ultimachine/RAMBo-1.4/Project Outputs/Assembly/BOM-Grouped_RAMBo_1.4a.xlsx

Designator | DISTRIBUTOR | DISTRIBUTOR # | Manufacturer | MANUFACTURER # | PART | Quantity | DNI | Comment | Footprint | Description | Part Description | VALUE | Tolerance | EE_SPEC
C1, C12, C13, C57, C58 |  |  | TDK | C1608C0G1H220J |  | 5 |  | 22pF | C0603 | CAPACITOR, European symbol |  |  |  | 22pF 50V capacitor
C2 |  |  | Kemet | C0805C106K8PACTU |  | 1 |  | 10uF | C0805 | CAPACITOR, American symbol |  |  |  | 10uF
C3, C5, C6, C7, C8, C9, C19, C20, C21, C26, C52, C53, C56, C59, C64, C78, C86, C87, C88, C89, C90, C91, C92, C93, C94, C95, C96, C97 | Digi-Key, [NoParam], Digikey, Digikey, Digikey, Digikey, [NoParam], [NoParam], [NoParam], Digikey, Digikey, Digi-Key, Digi-Key, Digi-Key, Digi-Key, Digikey, [NoParam], [NoParam], [NoParam], [NoParam], [NoParam], [NoParam], Digikey, Digikey, Digikey, Digikey, Digi-Key, Digikey | 490-3261-2-ND | Murata | GRM155R71C104KA88D | 100nF, [NoParam], 0.1uF 16V X7R 0402, 0.1uF 16V X7R 0402, 0.1uF 16V X7R 0402, 0.1uF 16V X7R 0402, [NoParam], [NoParam], [NoParam], 0.1uF 16V X7R 0402, 0.1uF 16V X7R 0402, 100nF, 100nF, 100nF, 100nF, 0.1uF 16V X7R 0402, [NoParam], [NoParam], [NoParam], [NoParam], [NoParam], [NoParam], 0.1uF 16V X7R 0402, 0.1uF 16V X7R 0402, 0.1uF 16V X7R 0402, 0.1uF 16V X7R 0402, 100nF, 0.1uF 16V X7R 0402 | 28 |  | 100nF | C0402 | CAP CER 0402 100nF 16V 10% X7R, CAPACITOR, European symbol, CAP CER 0402 100nF 16V 10% X7R, CAP CER 0402 100nF 16V 10% X7R, CAP CER 0402 100nF 16V 10% X7R, CAP CER 0402 100nF 16V 10% X7R, CAPACITOR, European symbol, CAPACITOR, European symbol, CAPACITOR, European symbol, CAP CER 0402 100nF 16V 10% X7R, CAP CER 0402 100nF 16V 10% X7R, CAP CER 0402 100nF 16V 10% X7R, CAP CER 0402 100nF 16V 10% X7R, CAP CER 0402 100nF 16V 10% X7R, CAP CER 0402 100nF 16V 10% X7R, CAP CER 0402 100nF 16V 10% X7R, CAPACITOR, European symbol, CAPACITOR, European symbol, CAPACITOR, European symbol, CAPACITOR, European symbol, CAPACITOR, European symbol, CAPACITOR, European symbol, CAP CER 0402 100nF 16V 10% X7R, CAP CER 0402 100nF 16V 10% X7R, CAP CER 0402 100nF 16V 10% X7R, CAP CER 0402 100nF 16V 10% X7R, CAP CER 0402 100nF 16V 10% X7R, CAP CER 0402 100nF 16V 10% X7R | 0.10µF ±10% 16V Ceramic Capacitor X7R 0402 (1005 Metric) | 100nF | +/- 10%, [NoParam], 10%, 10%, 10%, 10%, [NoParam], [NoParam], [NoParam], 10%, 10%, +/- 10%, +/- 10%, +/- 10%, +/- 10%, 10%, [NoParam], [NoParam], [NoParam], [NoParam], [NoParam], [NoParam], 10%, 10%, 10%, 10%, +/- 10%, 10% | 100nF 16V X7R 0402, 16V, 16V, 16V, 16V, 16V, 16V, 16V, 16V, 16V, 16V, 100nF 16V X7R 0402, 100nF 16V X7R 0402, 100nF 16V X7R 0402, 100nF 16V X7R 0402, 16V, 16V, 16V, 16V, 16V, 16V, 16V, 16V, 16V, 16V, 16V, 100nF 16V X7R 0402, 16V
C4, C10, C11, C14, C15, C17, C18, C23, C24, C27, C28, C29, C32, C33, C34, C37, C38, C39, C42, C43, C44, C47, C48, C49, C55, C60, C62, C71, C72, C73, C74, C75 |  |  | Kemet, Kemet, Kemet, Kemet, Kemet, Kemet, Kemet, Kemet, Kemet, Kemet, Kemet, Kemet, Kemet, Kemet, Kemet, Kemet, Kemet, Kemet, Kemet, Kemet, Kemet, Kemet, Kemet, Kemet, Kemet, [NoValue], [NoValue], Kemet, Kemet, Kemet, Kemet, Kemet | C0603C104K5RACTU |  | 32 |  | 100nF | C0603 | CAPACITOR, European symbol, CAPACITOR, European symbol, CAPACITOR, European symbol, CAPACITOR, European symbol, CAPACITOR, European symbol, CAPACITOR, European symbol, CAPACITOR, European symbol, CAPACITOR, European symbol, CAPACITOR, European symbol, CAPACITOR, European symbol, CAPACITOR, European symbol, CAPACITOR, European symbol, CAPACITOR, European symbol, CAPACITOR, European symbol, CAPACITOR, European symbol, CAPACITOR, European symbol, CAPACITOR, European symbol, CAPACITOR, European symbol, CAPACITOR, European symbol, CAPACITOR, European symbol, CAPACITOR, European symbol, CAPACITOR, European symbol, CAPACITOR, European symbol, CAPACITOR, European symbol, CAPACITOR, European symbol, CAP CER 0603 100nF 50V 10% X7R, CAP CER 0603 100nF 50V 10% X7R, CAPACITOR, European symbol, CAPACITOR, European symbol, CAPACITOR, European symbol, CAPACITOR, European symbol, CAPACITOR, European symbol |  |  |  | 0.1uF 50V capacitor
C16 |  |  | yageo | CC0603ZRY5V6BB105 |  | 1 |  | 1uF | C0603 | CAPACITOR, European symbol |  |  |  | 1uF 10V capacitor
C22, C50, C61, C67, C68, C69, C70, C77, C79, C80, C81, C82, C83, C84, C85 |  |  | Murata | GRM1555C1H101JA01D |  | 15 |  | 100pF | C0402 | Capacitor Non Polarized |  | C0402TBD |  | 100pF ±5% 50V Ceramic Capacitor C0G, NP0 0402 (1005 Metric)
C25, C30, C45 | Digikey | 490-9964-2-ND | Murata | GRM319R6YA106KA12D | 10uF 35V X5R 1206 | 3 | DNI | 10uF | C1206 | CAP CER 10UF 35V 10% X5R 1206 | 10µF ±10% 35V Ceramic Capacitor X5R 1206 (3216 Metric) | 10uF | 10% | 35V
C31, C36, C41, C46, C51 |  |  | Yageo | CC0603KRX7R7BB224 |  | 5 |  | 0.22uF | C0603 | CAPACITOR, European symbol |  |  |  | 0.22uF 100V capacitor X or 15%
C35, C54 |  |  | TDK | C1608X7R1E103K080AA |  | 2 |  | 10nF | C0603 | CAPACITOR, American symbol |  |  |  | 10nF (0.01uF) 25V capacitor
C40 |  |  | Murata | GRM21BR71H105KA12L |  | 1 |  | 1uF | C0805 | CAPACITOR, American symbol |  |  |  | Multilayer Ceramic Capacitors MLCC - SMD/SMT 1.0UF 50V 10% 0805
C63 |  |  |  | CC0402KRX7R8BB472 |  | 1 |  | 4.7nF | C0402 | CAPACITOR, European symbol |  |  |  | Multilayer Ceramic Capacitors MLCC - SMD/SMT 4.7nF 25V X7R 10%
C65, C66 |  |  | Nichicon | UVZ1H101MPD1TD |  | 2 |  | 100uF | E3,5-8 | POLARIZED CAPACITOR, American symbol |  |  |  | Aluminum Electrolytic Capacitors - Leaded 100uF 50V 20% 105c
C76 |  |  | nichicon | UPW1H471MHD1TO |  | 1 |  | 470uF | C12,5-5 | POLARIZED CAPACITOR, American symbol |  |  |  | CAPACITOR ALUM ELEC, 470UF, 50V, 20%, RADIAL
CF1, CF2, CF3, CF4, CF5, CF6, CF7, CF8, CF9, CF10, CF11, CF12, CF13, CF14, CF15, CF16, CF17, CF18, CF19, CF20 |  |  |  | NFM21CC223R1H3D |  | 20 |  | NFM21C | NFM21C | EMIFIL(R) (Capacitor type) Single Circuit Type for Signal Lines Source: http://search.murata.co.jp/Ceramy/image/img/PDF/ENG/L0111S0109NFM3DC.pdf |  |  |  | EMI Filter 2A 50VDC Flat Style SMD
D1, D3, D6, D10, D20 |  |  | Diodes Inc. | SK310A-TP |  | 5 |  | SK310A-TP | SMA-SM | Schottky Diode |  |  |  | 3.0A 100V Diode
D2, D8, D9, D21, D22, D23, D24, D25, D26, D27, D28, D29, D30, D31, D32, D33, D34, D35, D36, D37, D38, D39 | Digi-Key | SMAJ28A-FDITR-ND | Diodes Inc | SMAJ28A-13-F | SMAJ28A | 22 |  | SMAJ28A | SMA-SM | TVS DIODE 28VWM 45.4VC SMA | TVS DIODE 28VWM 45.4VC SMA | SMAJ28A | NA | 28Vrs 45.4Vc
D4, D5 |  |  | Bourns | CD1206-S01575 |  | 2 |  | CD1206-S01575 | MINIMELF | DIODE |  |  |  | 100V 150mA diode
D7 |  |  |  | S3A-13-F |  | 1 |  | S3A-13-F | DO-214AB | DIODE DO-214AB |  | S3A-13-F |  | 3A 50V Diode
D11, D12, D13, D14, D15, D16, D17, D18 | Digi-Key | BAT54WT-7DI-ND | Diodes Incorporated | BAT54WT-7 | BAT54 | 8 |  | BAT54 | SOD523_IPC | Diode Schottky 30V 100mA Surface Mount SOD-523 | Diode Schottky 30V 100mA Surface Mount SOD-523 | BAT54 | NA | 30V 0.1A
D40 |  |  |  | RSB39VTE-17 |  | 1 |  | RSB39VTE-17 | SOD323-R | DIODE uni and bidirectional supressor diode |  |  |  | TVS DIODE 30VWM SOD323
F1 |  |  | Bourns | MF-MSMF050-2 |  | 1 |  | MF-MSMF050-2 500mA | L1812 | INDUCTOR, European symbol |  |  |  | 500mA 15V fuse ptc reset
F2, F3 |  |  | Littlefuse | 0154005.DR |  | 2 |  | OMNI-BLOK | OMNI-BLOK |  |  |  |  | 5A fuse/fuse block
F4 |  |  | Keystone | 3587TR |  | 1 |  | FUSE | FUSE-ATO-SMD |  |  |  |  | FUSE HOLDER, AUTO BLADE, SMT
FB1, FB2, FB3, FB4, FB5, FB6, FB7, FB8, FB9, FB10, FB11, FB12, FB13, FB14, FB15, FB16, FB17, FB18, FB19, FB20, FB21, FB22, FB23, FB24, FB25, FB26, FB27, FB28, FB29, FB30, FB31, FB32 | Digikey | 587-1921-2-ND | Taiyo Yuden | BKP1005HS121-T | FERRITE 120R 1A 0402 | 32 |  | 120R | R0402 | FERRITE BEAD 120 OHM 0402 1LN | FERRITE BEAD 120 OHM 0402 1LN | 120Rfb | -NA- | 1A
FID1, FID2, FID3 |  |  |  |  |  | 3 |  | FIDUCIAL1X2.5 | FIDUCIAL-1X2.5 | Fiducial Alignment PointsVarious fiducial points for machine vision alignment.
JP2 |  |  |  |  |  | 1 |  | SJ | SJ | SMD solder JUMPER
JP3, X35, X36, X37, X38 |  |  |  |  |  | 5 |  | M02PTH | 1X02 | Header 2Standard 2-pin 0.1" header. Use with straight break away headers (SKU : PRT-00116), right angle break away headers (PRT-00553), swiss pins (PRT-00743), machine pins (PRT-00117), and female headers (PRT-00115). Molex polarized connector foot print use with SKU : PRT-08233 with associated crimp pins and housings.
L1, L4 |  |  |  | BLM41PG600SN1L |  | 2 |  | BLM41PG600SN1 | L1806 | FERRITE BEAD 1806 60ohm |  |  |  | FERRITE CHIP 60 OHM 6000MA 1806
L2 |  |  | Taiyo Yuden | CBC2012T100M |  | 1 |  | 10uH | C0805 | INDUCTOR, American symbol |  |  |  | INDUCTOR 10UH 20% 0805 SMD
L3 | Digi-Key | SRN8040-330M | Bourns | SRN8040-330M | FIXED IND 33UH 1.7A 145 MOHM SMD | 1 |  | 33uH | INDP8080X40L | FIXED IND 33UH 1.7A 145 MOHM SMD | Semi-Shielded Wirewound Inductor 145 mOhm Max Nonstandard | 33uH | +/- 20% | FIXED IND 33UH 1.7A 145 MOHM SMD
LED1, LED9, LED10 |  |  | Dialight | 5988140107F |  | 3 |  | YELLOW | CHIP-LED0805 | LED OSRAM: - CHIPLED LG R971, LG N971, LY N971, LG Q971, LY Q971, LO R971, LY R971 LH N974, LH R974 LS Q976, LO Q976, LY Q976 LO Q996 - Hyper CHIPLED LW Q18S LB Q993, LB Q99A, LB R99A - SideLED LS A670, LO A670, LY A670, LG A670, LP A670 LB A673, LV A673, LT A673, LW A673 LH A674 LY A675 LS A676, LA A676, LO A676, LY A676, LW A676 LS A679, LY A679, LG A679 - Hyper Micro SIDELED® LS Y876, LA Y876, LO Y876, LY Y876 LT Y87S - SmartLED LW L88C, LW L88S LB L89C, LB L89S, LG L890 LS L89K, LO L89K, LY L89K LS L896, LA L896, LO L896, LY L896 - TOPLED LS T670, LO T670, LY T670, LG T670, LP T670 LSG T670, LSP T670, LSY T670, LOP T670, LYG T670 LG T671, LOG T671, LSG T671 LB T673, LV T673, LT T673, LW T673 LH T674 LS T676, LA T676, LO T676, LY T676, LB T676, LH T676, LSB T676, LW T676 LB T67C, LV T67C, LT T67C, LS T67K, LO T67K, LY T67K, LW E67C LS E67B, LA E67B, LO E67B, LY E67B, LB E67C, LV E67C, LT E67C LW T67C LS T679, LY T679, LG T679 LS T770, LO T770, LY T770, LG T770, LP T770 LB T773, LV T773, LT T773, LW T773 LH T774 LS E675, LA E675, LY E675, LS T675 LS T776, LA T776, LO T776, LY T776, LB T776 LHGB T686 LT T68C, LB T68C - Hyper Mini TOPLED® LB M676 - Mini TOPLED Santana® LG M470 LS M47K, LO M47K, LY M47K Source: http://www.osram.convergy.de LUXEON: - LUMILED® LXK2-PW12-R00, LXK2-PW12-S00, LXK2-PW14-U00, LXK2-PW14-V00 LXK2-PM12-R00, LXK2-PM12-S00, LXK2-PM14-U00 LXK2-PE12-Q00, LXK2-PE12-R00, LXK2-PE12-S00, LXK2-PE14-T00, LXK2-PE14-U00 LXK2-PB12-K00, LXK2-PB12-L00, LXK2-PB12-M00, LXK2-PB14-N00, LXK2-PB14-P00, 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 |  |  |  | YELLOW LED
LED2, LED3, LED4, LED5, LED6, LED8 |  |  | Dialight | 5988110107F |  | 6 |  | RED | CHIP-LED0805 | LED OSRAM: - CHIPLED LG R971, LG N971, LY N971, LG Q971, LY Q971, LO R971, LY R971 LH N974, LH R974 LS Q976, LO Q976, LY Q976 LO Q996 - Hyper CHIPLED LW Q18S LB Q993, LB Q99A, LB R99A - SideLED LS A670, LO A670, LY A670, LG A670, LP A670 LB A673, LV A673, LT A673, LW A673 LH A674 LY A675 LS A676, LA A676, LO A676, LY A676, LW A676 LS A679, LY A679, LG A679 - Hyper Micro SIDELED® LS Y876, LA Y876, LO Y876, LY Y876 LT Y87S - SmartLED LW L88C, LW L88S LB L89C, LB L89S, LG L890 LS L89K, LO L89K, LY L89K LS L896, LA L896, LO L896, LY L896 - TOPLED LS T670, LO T670, LY T670, LG T670, LP T670 LSG T670, LSP T670, LSY T670, LOP T670, LYG T670 LG T671, LOG T671, LSG T671 LB T673, LV T673, LT T673, LW T673 LH T674 LS T676, LA T676, LO T676, LY T676, LB T676, LH T676, LSB T676, LW T676 LB T67C, LV T67C, LT T67C, LS T67K, LO T67K, LY T67K, LW E67C LS E67B, LA E67B, LO E67B, LY E67B, LB E67C, LV E67C, LT E67C LW T67C LS T679, LY T679, LG T679 LS T770, LO T770, LY T770, LG T770, LP T770 LB T773, LV T773, LT T773, LW T773 LH T774 LS E675, LA E675, LY E675, LS T675 LS T776, LA T776, LO T776, LY T776, LB T776 LHGB T686 LT T68C, LB T68C - Hyper Mini TOPLED® LB M676 - Mini TOPLED Santana® LG M470 LS M47K, LO M47K, LY M47K Source: http://www.osram.convergy.de LUXEON: - LUMILED® LXK2-PW12-R00, LXK2-PW12-S00, LXK2-PW14-U00, LXK2-PW14-V00 LXK2-PM12-R00, LXK2-PM12-S00, LXK2-PM14-U00 LXK2-PE12-Q00, LXK2-PE12-R00, LXK2-PE12-S00, LXK2-PE14-T00, LXK2-PE14-U00 LXK2-PB12-K00, LXK2-PB12-L00, LXK2-PB12-M00, LXK2-PB14-N00, LXK2-PB14-P00, 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 |  |  |  | RED
LED7 |  |  |  | 598-8170-107F |  | 1 |  | GREEN | CHIP-LED0805 | LED OSRAM: - CHIPLED LG R971, LG N971, LY N971, LG Q971, LY Q971, LO R971, LY R971 LH N974, LH R974 LS Q976, LO Q976, LY Q976 LO Q996 - Hyper CHIPLED LW Q18S LB Q993, LB Q99A, LB R99A - SideLED LS A670, LO A670, LY A670, LG A670, LP A670 LB A673, LV A673, LT A673, LW A673 LH A674 LY A675 LS A676, LA A676, LO A676, LY A676, LW A676 LS A679, LY A679, LG A679 - Hyper Micro SIDELED® LS Y876, LA Y876, LO Y876, LY Y876 LT Y87S - SmartLED LW L88C, LW L88S LB L89C, LB L89S, LG L890 LS L89K, LO L89K, LY L89K LS L896, LA L896, LO L896, LY L896 - TOPLED LS T670, LO T670, LY T670, LG T670, LP T670 LSG T670, LSP T670, LSY T670, LOP T670, LYG T670 LG T671, LOG T671, LSG T671 LB T673, LV T673, LT T673, LW T673 LH T674 LS T676, LA T676, LO T676, LY T676, LB T676, LH T676, LSB T676, LW T676 LB T67C, LV T67C, LT T67C, LS T67K, LO T67K, LY T67K, LW E67C LS E67B, LA E67B, LO E67B, LY E67B, LB E67C, LV E67C, LT E67C LW T67C LS T679, LY T679, LG T679 LS T770, LO T770, LY T770, LG T770, LP T770 LB T773, LV T773, LT T773, LW T773 LH T774 LS E675, LA E675, LY E675, LS T675 LS T776, LA T776, LO T776, LY T776, LB T776 LHGB T686 LT T68C, LB T68C - Hyper Mini TOPLED® LB M676 - Mini TOPLED Santana® LG M470 LS M47K, LO M47K, LY M47K Source: http://www.osram.convergy.de LUXEON: - LUMILED® LXK2-PW12-R00, LXK2-PW12-S00, LXK2-PW14-U00, LXK2-PW14-V00 LXK2-PM12-R00, LXK2-PM12-S00, LXK2-PM14-U00 LXK2-PE12-Q00, LXK2-PE12-R00, LXK2-PE12-S00, LXK2-PE14-T00, LXK2-PE14-U00 LXK2-PB12-K00, LXK2-PB12-L00, LXK2-PB12-M00, LXK2-PB14-N00, LXK2-PB14-P00, 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 |  |  |  | GREEN LED
LOGO1 |  |  |  |  |  | 1 |  | OSHW_LOGO_8MILX0150-NT | OSHW_8X150_NOTEXT
P1, P2 | Digikey | ED1543-ND | On Shore | 302-S101 | HDR10 | 2 |  | HDR10 | HDR2X5 IDC | CONN HEADER VERT 10POS GOLD | 10 Positions Header Connector 0.100" (2.54mm) Through Hole Gold | HDR10 | -NA- | -NA-
Q1, Q2, Q3, Q5 | Digikey | 1727-1052-2-ND | Nexperia | PSMN1R8-40YLC,115 |  | 4 |  | PSMN1R8-40YLC | SOT669 | MOSFET N-CH 40V 100A LFPAK | N-Channel 40V 100A (Tc) 272W (Tc) Surface Mount LFPAK56, Power-SO8 | N-FET | -NA- | 40V 100A 1.8mOhm
Q4 | Digi-Key | NCV8402ADDR2GOSTR-ND | On Semi | NCV8402ADDR2G | NCV8402 | 1 |  | NCV8402AD | NCV8402AD-SOIC8 | IC DVR LOW SIDE 8-SOIC | IC DVR LOW SIDE 8-SOIC | NCV8402 | NA | 42Vmaz 2A 0.165-Ohm
R1, R2, R64, R74, R75, R76 |  |  | Yageo | RC0402FR-0722RL |  | 6 |  | 22R | R0402 | RESISTOR, American symbol |  |  |  | 22R (22ohm) 62.5mW 1% resistor
R3 |  |  | Vishay | CRCW0603470KFKEA |  | 1 |  | 470K | R0603 | RESISTOR, American symbol |  |  |  | SMD 1/10watt 470Kohms 1% Thick Film Resistors
R4, R7, R8, R10, R14, R15, R19, R20, R23, R24 |  |  | Bourns | CRM1206-FX-R100ELF |  | 10 |  | 0r1 | R1206 | RESISTOR, American symbol |  |  |  | 0r1 (0.1ohm) .5mW 1% resistor
R5, R6, R9, R16, R21, R25 | Digi-Key | YAG1249TR-ND | Yageo | RC0402FR-0710KP | 10k 1% 0402 | 6 |  | 10K | R0402 | RES SMD 10K OHM 1% 1/16W 0402 | 10k Ohm ±1% 0.063W, 1/16W Chip Resistor 0402 (1005 Metric) Moisture Resistant Thick Film | 10K | 1% | 10k 1% 0402
R11, R13 |  |  |  |  |  | 2 |  | NP | R0603 | RESISTOR, American symbol
R12, R17, R18, R22, R26 |  |  | Bourns | CR0603J000ELF |  | 5 |  | 0r | R0603 | RESISTOR, American symbol |  |  |  | 0r (zero ohm) 100mW 5% resistor
R27, R28, R32, R36, R38, R39, R77, R78 | Digi-Key | 311-2.37KLRTR-ND | Yageo | RC0402FR-072K37L | 2.37k | 8 |  | 2k37 | R0402 | RES SMD 2.37K OHM 1% 1/16W 0402 | 2.37k Ohm ±1% 0.063W, 1/16W Chip Resistor 0402 (1005 Metric) Moisture Resistant Thick Film | 2k37 | +/- 1% | 2.37k 1% 0402
R29, R65, R66, R67, R68 |  |  | Vishay | CRCW060356R0JNEA |  | 5 |  | 56r | R0603 | RESISTOR, American symbol |  |  |  | RESISTOR, THICK FILM, 56OHM, 100mW, 5%
R30 |  |  | panasonic | erj3geyj332v |  | 1 |  | 3.3K | R0603 | RESISTOR, American symbol |  |  |  | RESISTOR, THICK FILM, 3.3KOHM, 100mW, 5%
R31, R37, R73, R79 | Digi-Key | 311-4.7KLRTR-ND | Yageo | RC0402FR-074K7L | 4.7k | 4 |  | 4.7k | R0402 | RES SMD 4.7K OHM 1% 1/16W 0402 | 4.7k Ohm ±1% 0.063W, 1/16W Chip Resistor 0402 (1005 Metric) Moisture Resistant Thick Film | 4.7k | +/- 1% | 4.7k 1% 0402
R33, R34, R35 |  |  | Panasonic | ERJ-3EKF1001V |  | 3 |  | 1K | R0603 | RESISTOR, American symbol |  |  |  | RESISTOR, THICK FILM, 1KOHM, 100mW, 1%
R40, R41, R50, R55, R58, R69 |  |  |  | RC0603JR-071K8L |  | 6 |  | 1.8K | R0603 | RESISTOR, American symbol |  |  |  | Resistor, Thick Film, 1.8K Ohm, 50V, 5±%, 100ppm, 0603 Case Size
R42, R48, R51, R53, R56, R70 | Digikey | 311-100LRTR-ND | Yageo | RC0402FR-07100RL | 100R 1% 0402 | 6 |  | 100R | R0402 | RES SMD 100 OHM 1% 1/16W 0402 | 100 Ohm ±1% 0.063W, 1/16W Chip Resistor 0402 (1005 Metric) Moisture Resistant Thick Film | 100R | 1% | 1/16W
R43, R49, R52, R54, R57, R59, R60, R61, R62, R63, R71 |  |  | Yageo | RC0603FR-07100KL |  | 11 |  | 100K | R0603 | RESISTOR, American symbol |  |  |  | 100Kohm 100mW 1% resistor
R44, R45, R46, R47 |  |  | Panasonic | ERJ-3EKF1002V |  | 4 |  | 10K | R0603 | RESISTOR, American symbol |  |  |  | 10Kohm 100mW 1% resistor
R72 |  |  | Panasonic | ERJ2GEJ105X |  | 1 |  | 1M | R0402 | RESISTOR, American symbol |  |  |  | RES 1M OHM 1/10W 5% 0402 SMD
RN5 |  |  | Bourns | CAY16-102J4LF |  | 1 |  | 1k | CAY16 | RES ARRAY 4 RES 1K OHM 1206 |  |  |  | 1k Ohm ±5% 62.5mW Power Per Element Isolated 4 Resistor Network/Array ±200ppm/°C 1206 (3216 Metric), Convex, Long Side Terminals
RV1, RV2, RV3, RV4, RV5, RV6, RV7, RV8, RV9, RV10, RV11, RV12, RV13, RV14, RV15, RV16, RV17, RV18, RV19, RV20, RV21, RV22, RV23, RV24, RV25, RV26, RV27, RV28, RV29, RV30, RV31, RV32, RV33, RV34 | Digi-Key | 311-1516-2-ND | Yageo | VRS0402SR55R101N | 12V | 34 |  | VRS0402SR55R101N | C0402 | Multi-Layer Varistor | VARISTOR 12V 10A 0402 | 12V | NA | 5.5Vdc 12Vvar 60pF
S1 |  |  | Omron | 1571610-2 |  | 1 |  | 31-XX | B3F-31XX | OMRON SWITCHNow with beefier pads! |  |  |  | SWITCH, TACTILE, SPST-NO, 50mA, THD
TP0, TP1, TP2, TP3, TP4, TP5, TP6, TP7, TP8, TP9, TP10, TP11, TP12, TP13, TP14, TP15, TP16, TP17, TP18, TP19 |  |  |  |  |  | 20 |  | PTR1B1,27TH | B1,27TH | TEST PIN
TP20, TP21, TP22, TP23 |  |  |  |  |  | 4 |  | PTR1B1,27 | B1,27 | TEST PIN
TP24 |  |  |  |  |  | 1 |  | GND | 1X01 | Pin header 1x1 for 0.1" spacing With round pins
U1 |  |  | Atmel | ATMEGA32U2MU |  | 1 |  | ATMEGA32U2-MUR | QFN32TROUND |  |  |  |  | ATMEGA32U2-MUR (IC)
U2 | Digi-Key | ATMEGA2560-16AURTR-ND | Microchip | ATMEGA2560-16AUR | ATMEGA2560 | 1 |  | Atmega2560 | TSQFP50P1600X1600X120-100L | Atmega2560 | AVR AVR® ATmega Microcontroller IC 8-Bit 16MHz 256KB (128K x 16) FLASH 100-TQFP (14x14) | ATMEGA2560 | NA | 5V 256KB 8KB 16MHz
U3 |  |  |  | LM22675 |  | 1 |  | LM22675 | SOIC127P600X170-9N |  |  |  |  | IC REG BUCK 5V 1A 8SOPWRPAD
U4 |  |  | Analog Devices | AD5206BRUZ10-RL7 |  | 1 |  | AD5206 | TSSOP24 |  |  |  |  | AD5206 (IC)
U5, U6, U7, U8, U9 |  |  | Allegro | A4982SETTR-T |  | 5 |  | A4982 | QFN50P500X500X100_HS-33L |  |  |  |  | A4982
U10 |  |  | Analog Devices | ADUM7441ARQZ-RL7 |  | 1 |  | ADUM7441 | QSOP16 |  |  |  |  | ADUM7441
X1, X3, X5, X9, X27, X28, X29, X30 |  |  | Molex | 70543-0001 |  | 8 |  | C-GRID-02-70543 | 70543-02 | CONNECTOR wire to board 2.54 mm (0.100") pitch header |  |  |  | WIRE-BOARD CONNECTOR HEADER 2POS, 2.54MM
X2 |  |  | FCI | 61729-0010BLF |  | 1 |  | USB B-TH | PN61729 | BERG USB connector |  |  |  | USB B-TH connector
X4, X6, X7, X8, X10, X14, X15 |  |  | Molex | 70543-0038 |  | 7 |  | C-GRID-04-70543 | 4POL254, 4POL254, 4POL254, 4POL254, 70543-04, 4POL254, 4POL254 | PHOENIX CONNECTOR, PHOENIX CONNECTOR, PHOENIX CONNECTOR, PHOENIX CONNECTOR, CONNECTOR wire to board 2.54 mm (0.100") pitch header, PHOENIX CONNECTOR, PHOENIX CONNECTOR |  |  |  | WIRE-BOARD CONNECTOR HEADER 4POS, 2.54MM
X11 |  |  | Molex | 395311010 |  | 1 |  | MSTBV10 | MSTBV10 | PHOENIX |  |  |  | CONN HEADER 10POS 5.08MM STR TIN
X16 |  |  |  |  |  | 1 |  | 32u2 EXT | 2X8
X17, X18 |  |  |  | 2213S-06G |  | 2 |  | 3x2M | 2X03 | PIN HEADER |  |  |  | 2x3 header
X20 |  |  |  | 2211S-05G |  | 1 |  | MX1 | 1X05 | Header 5Standard 5-pin 0.1" header. Use with straight break away headers (SKU : PRT-00116), right angle break away headers (PRT-00553), swiss pins (PRT-00743), machine pins (PRT-00117), and female headers (PRT-00115). Molex polarized connector foot print use with SKU : PRT-08230 with associated crimp pins and housings. |  |  |  | 1x5
X21, X22, X23, X24, X25, X26 |  |  | Molex | 70543-0002 |  | 6 |  | C-GRID-03-70543 | 70543-03 | CONNECTOR wire to board 2.54 mm (0.100") pitch header |  |  |  | WIRE-BOARD CONNECTOR HEADER 3POS, 2.54MM
X31 |  |  |  | 2211S-05G |  | 1 |  | MX2 | 1X05 | Header 5Standard 5-pin 0.1" header. Use with straight break away headers (SKU : PRT-00116), right angle break away headers (PRT-00553), swiss pins (PRT-00743), machine pins (PRT-00117), and female headers (PRT-00115). Molex polarized connector foot print use with SKU : PRT-08230 with associated crimp pins and housings. |  |  |  | 1x5
X32 |  |  |  | 2211S-05G |  | 1 |  | MX3 | 1X05 | Header 5Standard 5-pin 0.1" header. Use with straight break away headers (SKU : PRT-00116), right angle break away headers (PRT-00553), swiss pins (PRT-00743), machine pins (PRT-00117), and female headers (PRT-00115). Molex polarized connector foot print use with SKU : PRT-08230 with associated crimp pins and housings. |  |  |  | 1x5
X33 |  |  | Molex | 39532-1006 |  | 1 |  | MSTBA6 | MSTBA6 | PHOENIX |  |  |  | 6 pin fixed terminal block
X34 |  |  |  | 2211S-06G |  | 1 |  | PWM_EXT | 1X06 | Header 6Standard 6-pin 0.1" header. Use with straight break away headers (SKU : PRT-00116), right angle break away headers (PRT-00553), swiss pins (PRT-00743), machine pins (PRT-00117), and female headers (PRT-00115). Molex polarized connector foot print use with SKU : PRT-08094 with associated crimp pins and housings. NOTES ON THE VARIANTS LOCK and LOCK_LONGPADS... This footprint was designed to help hold the alignment of a through-hole component (i.e. 6-pin header) while soldering it into place. You may notice that each hole has been shifted either up or down by 0.005 of an inch from it's more standard position (which is a perfectly straight line). This slight alteration caused the pins (the squares in the middle) to touch the edges of the holes. Because they are alternating, it causes a "brace" to hold the component in place. 0.005 has proven to be the perfect amount of "off-center" position when using our standard breakaway headers. Although looks a little odd when you look at the bare footprint, once you have a header in there, the alteration is very hard to notice. Also, if you push a header all the way into place, it is covered up entirely on the bottom side. This idea of altering the position of holes to aid alignment will be further integrated into the Sparkfun Library for other footprints. It can help hold any component with 3 or more connection pins. |  |  |  | 1x6 header
X39 |  |  |  | 2213S-10G |  | 1 |  | M05X2PTH | AVR_ICSP | Header 5x2Standard 10-pin dual row 0.1" header. Commonly used with AVR-ISP. Use with Spark Fun Electronics SKU: PRT-00778 |  |  |  | 2x5 header
X40 |  |  |  | 2213S-08G |  | 1 |  | Analog | 2X4
Y1, Y2 |  |  | TXC | 7M-16.000MEEQ-T |  | 2 |  | 16MHz KX-7 | CRYSTAL-3.2-2.5 |  |  |  |  | 16MHz KX-7 10ppm crystal
Z1, Z2, Z3 |  |  | Bourns | CG0603MLC-05E |  | 3 |  | CG0603MLC-05E | R0603 | RESISTOR, American symbol |  |  |  | 5V 20V varistor
