ultimachine/RAMBo-1.4/Project Outputs/RAMBo_Schematic Print.PDF

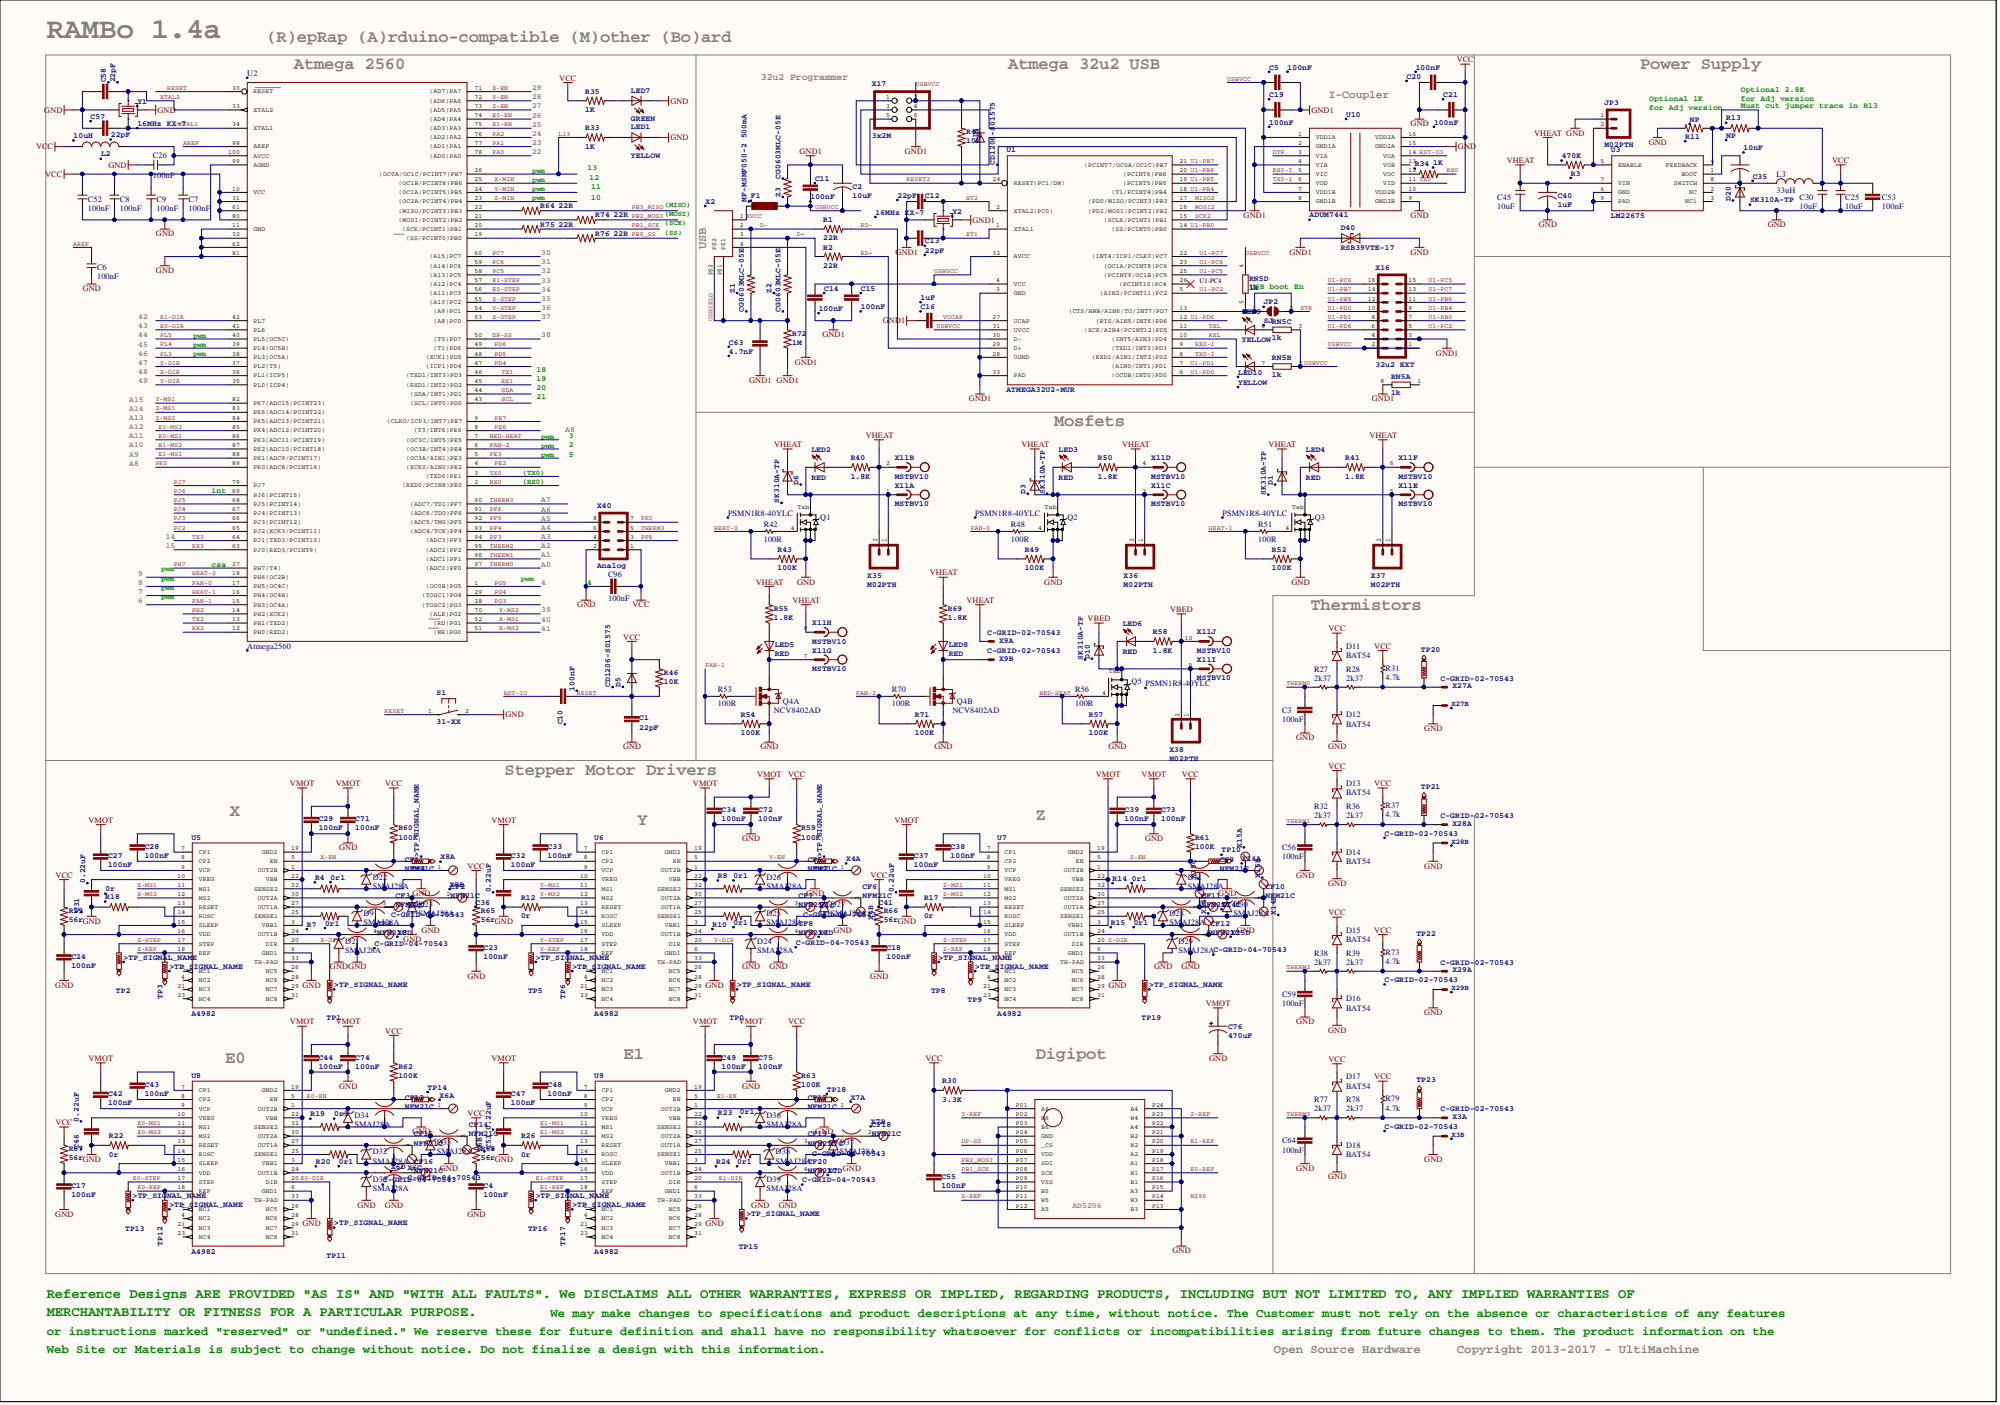
[picture p1: page 1]

(R)epRap (A)rduino-compatible (M)other (Bo)ard

Optional 2.8K
for Adj version Must cut jumper trace in R13

Reference Designs ARE PROVIDED "AS IS" AND "WITH ALL FAULTS". We DISCLAIMS ALL OTHER WARRANTIES, EXPRESS OR IMPLIED, REGARDING PRODUCTS, INCLUDING BUT NOT LIMITED TO, ANY IMPLIED WARRANTIES OF
MERCHANTABILITY OR FITNESS FOR A PARTICULAR PURPOSE.

We may make changes to specifications and product descriptions at any time, without notice. The Customer must not rely on the absence or characteristics of any features

or instructions marked "reserved" or "undefined." We reserve these for future definition and shall have no responsibility whatsoever for conflicts or incompatibilities arising from future changes to them. The product information on the
Web Site or Materials is subject to change without notice. Do not finalize a design with this information.

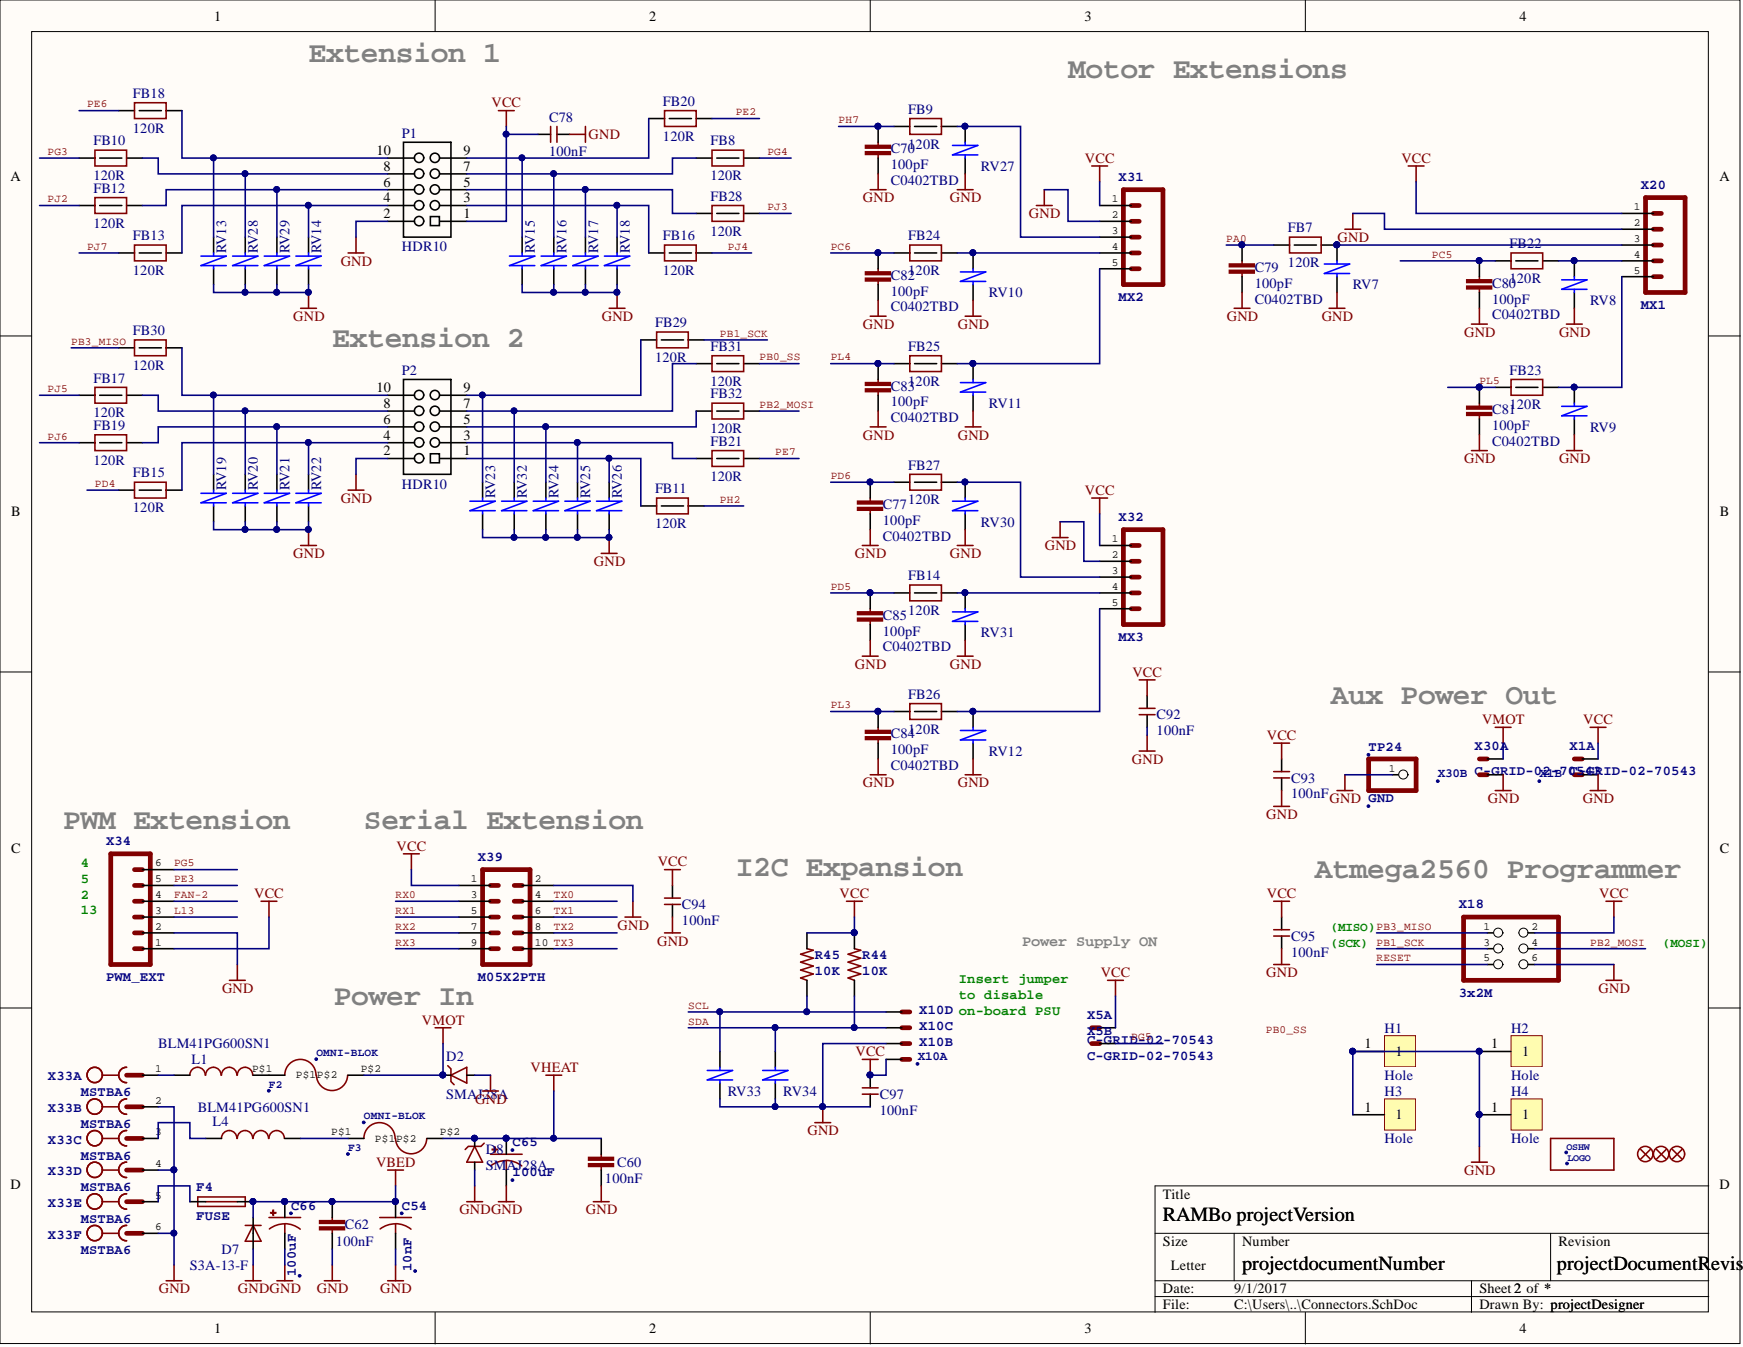
[picture p2: page 2]

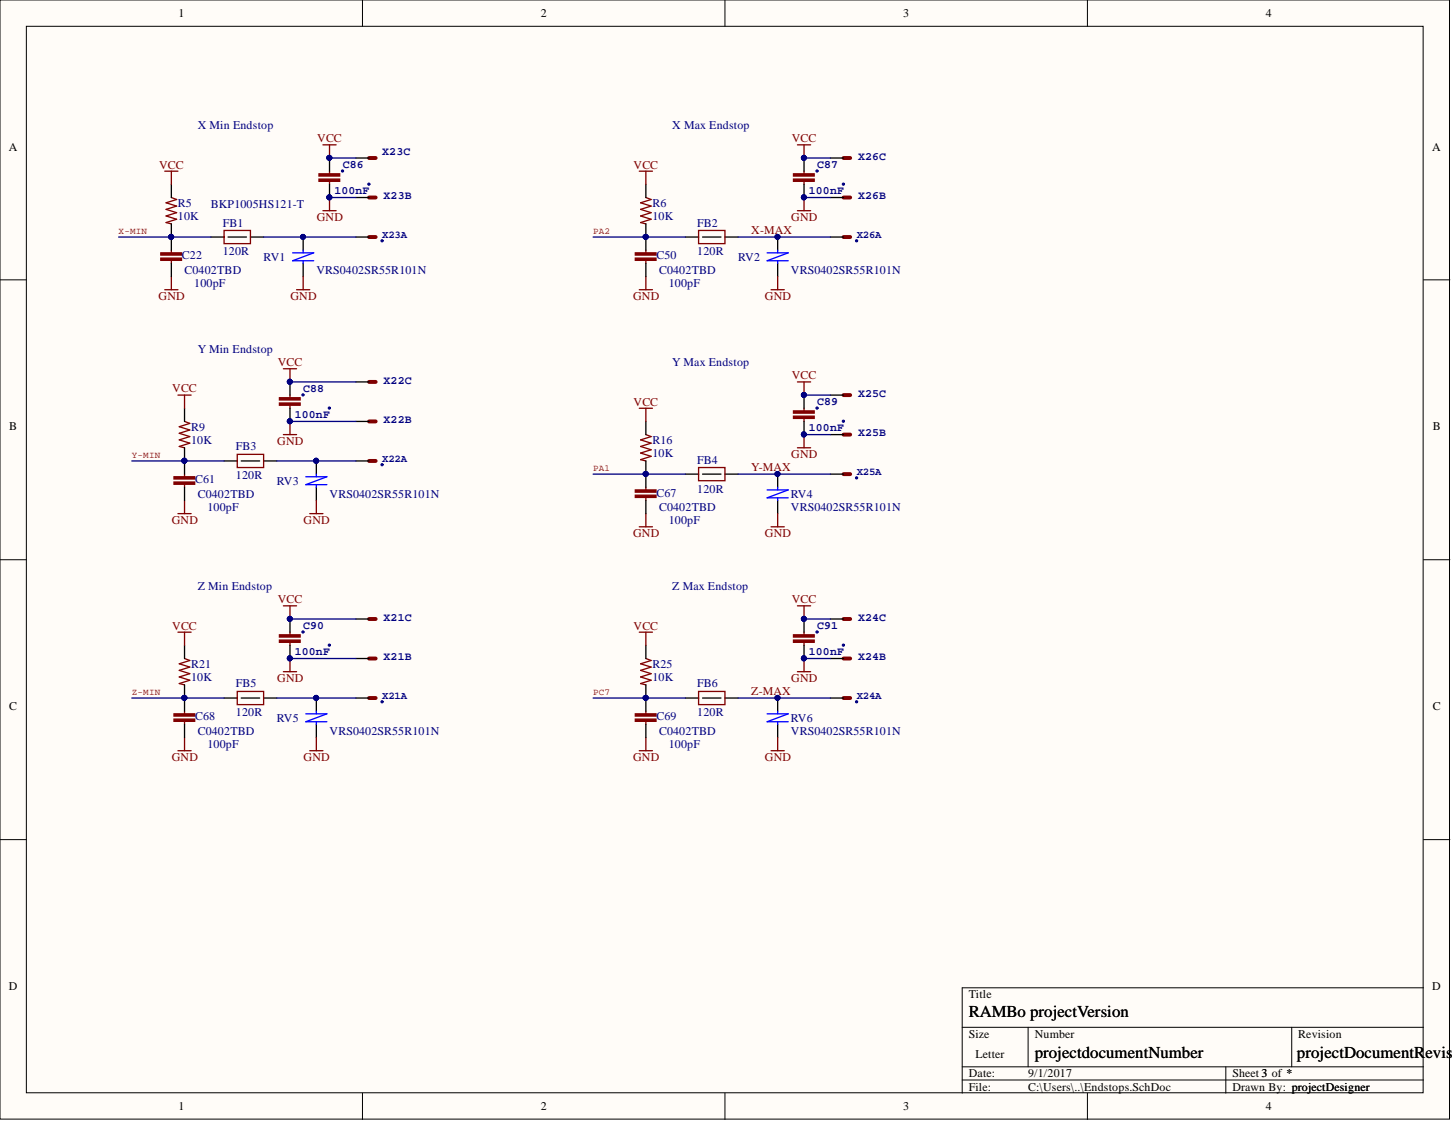
[picture p3: page 3]
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
