ultimachine/RAMBo-1.4/Project Outputs/Designators_RAMBo_1.4a.PDF

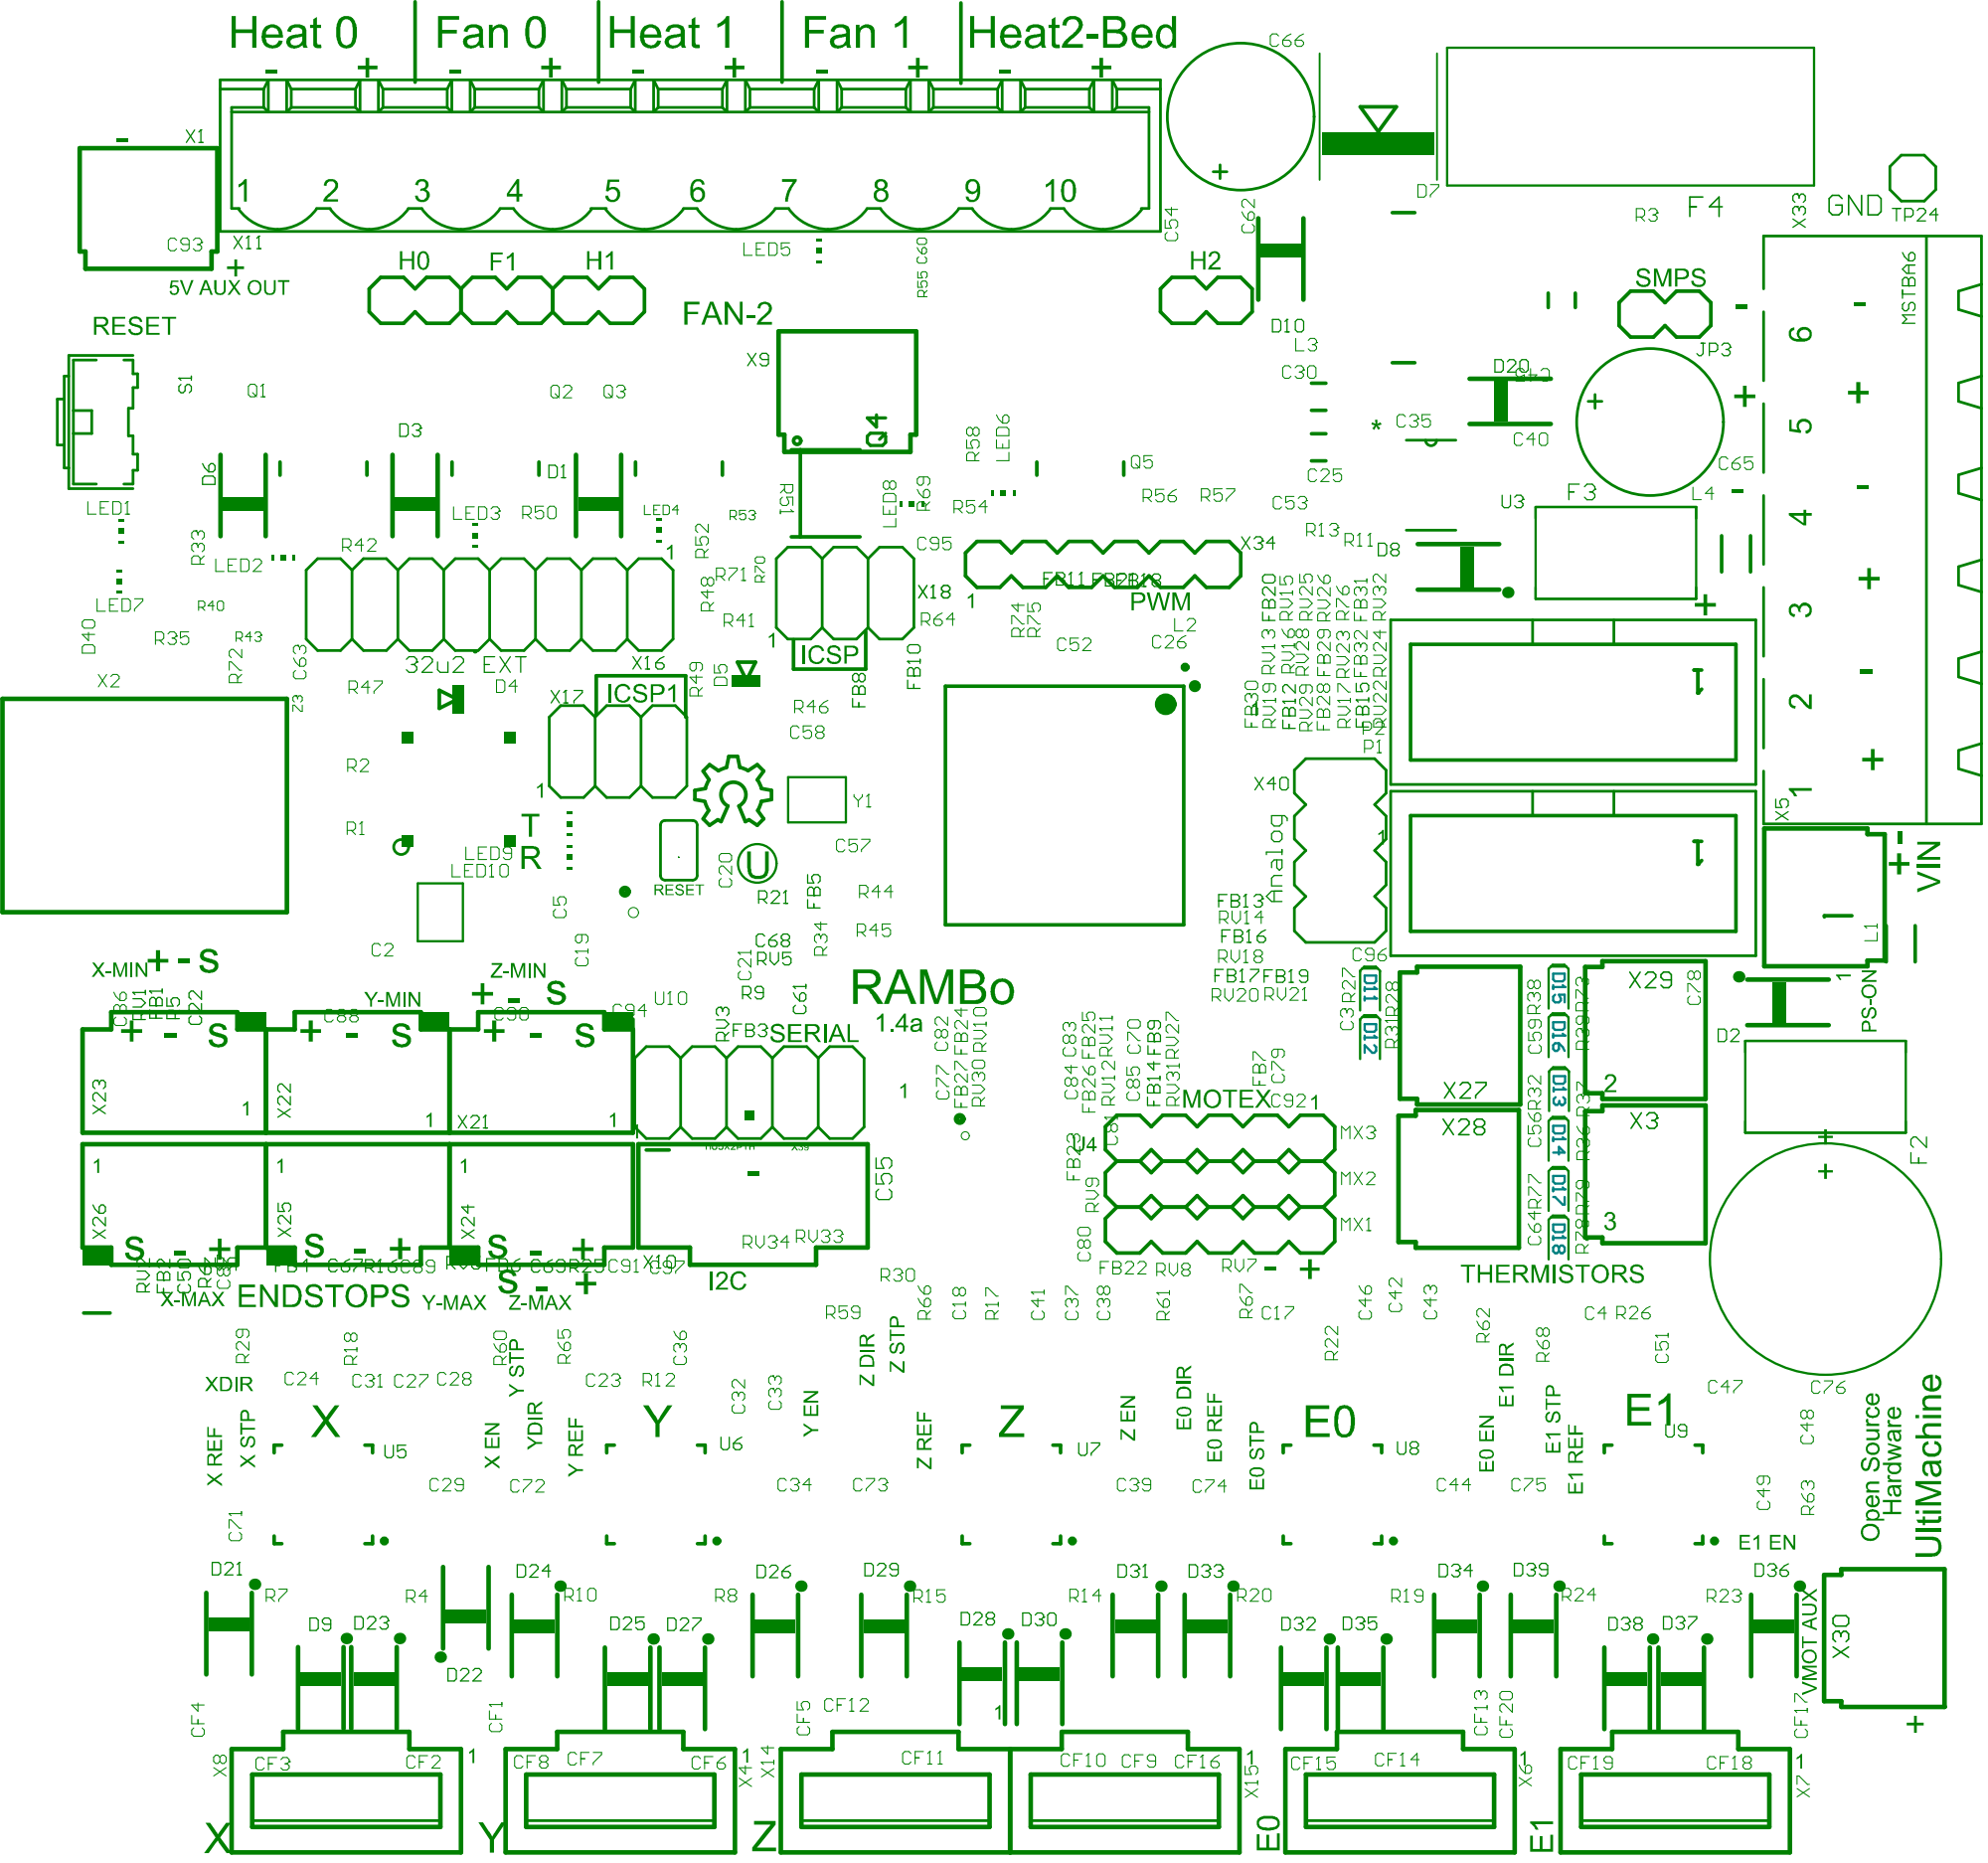
[picture p4: page 1]

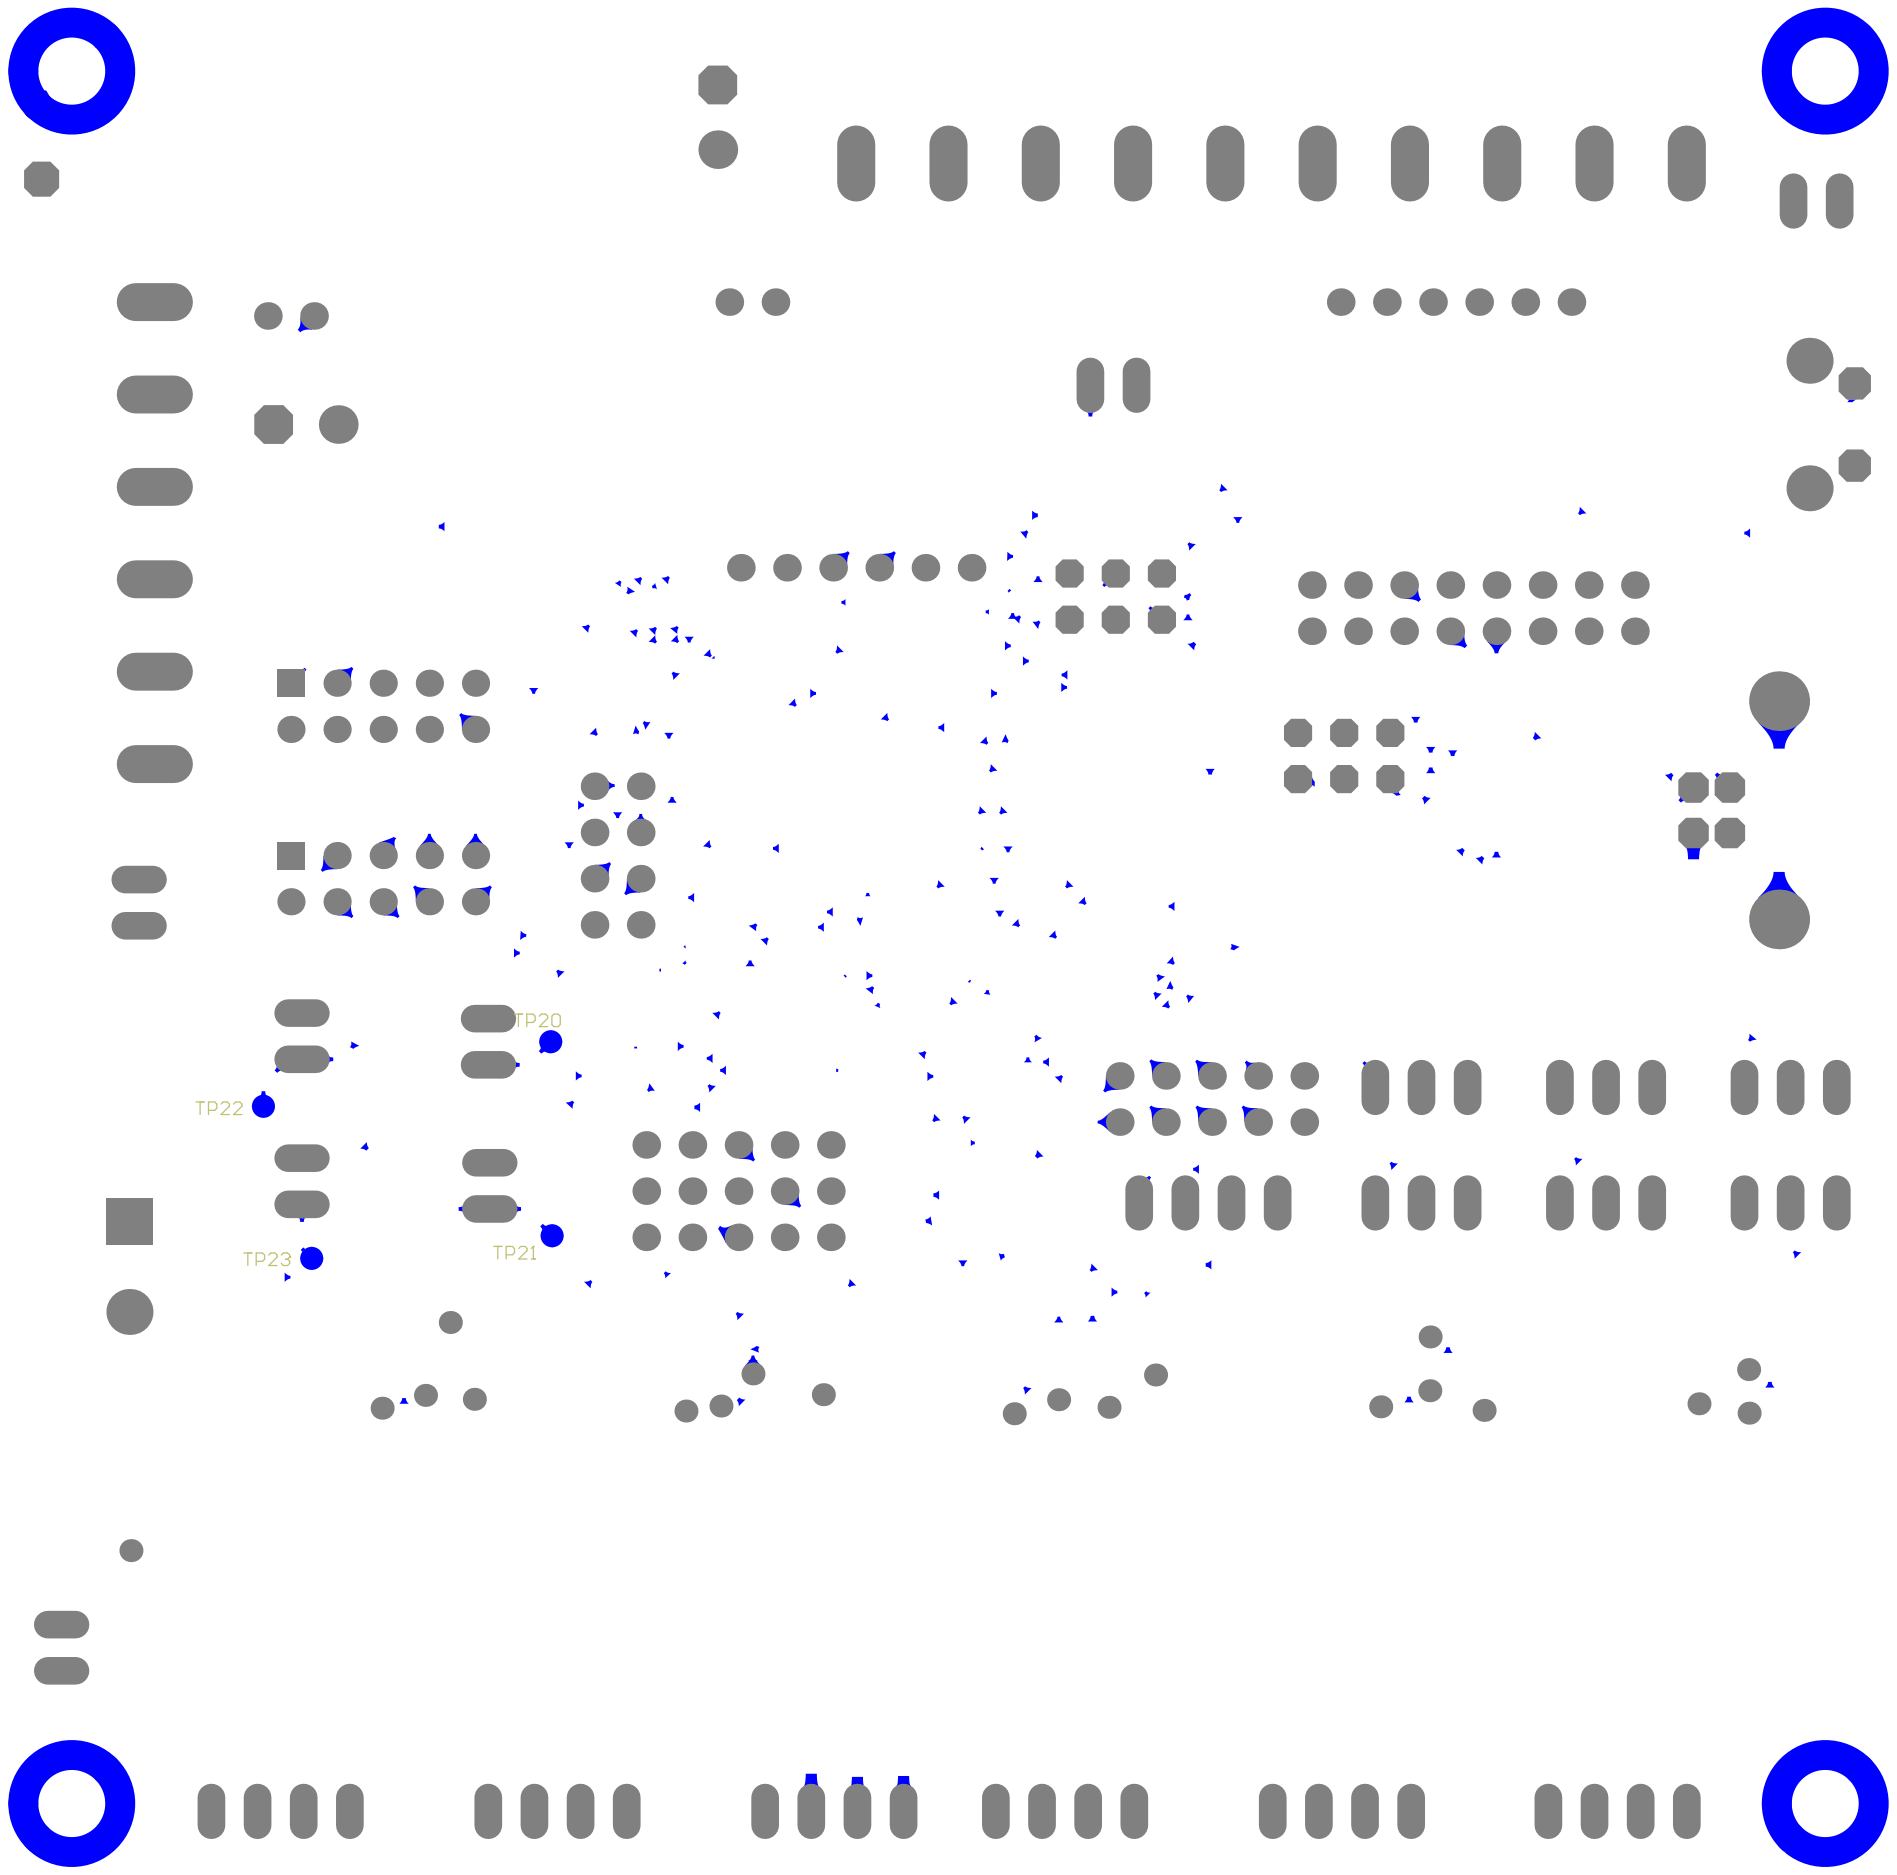
[picture p5: page 2]
