ultimachine/RAMBo-1.4/Project Outputs/PCB 3D Print (bottom)_RAMBo_1.4a.PDF

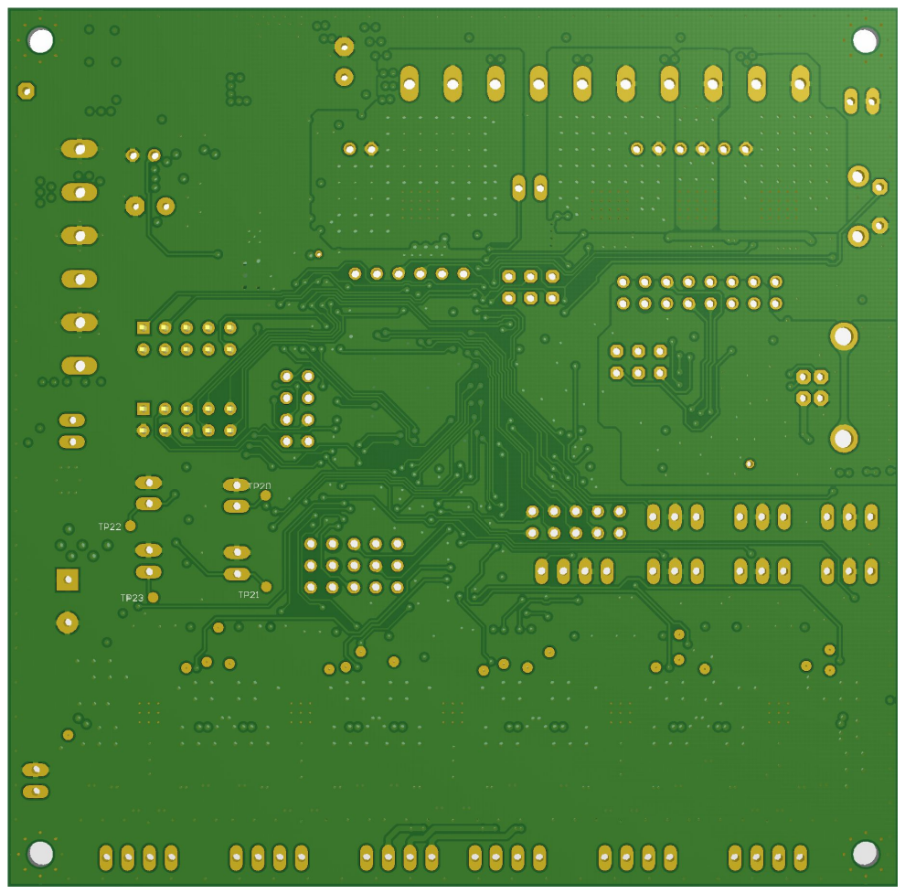
[picture p6: page 1]
