ultimachine/RAMBo-1.4/Project Outputs/PCB 3D Print (top)_RAMBo_1.4a.PDF

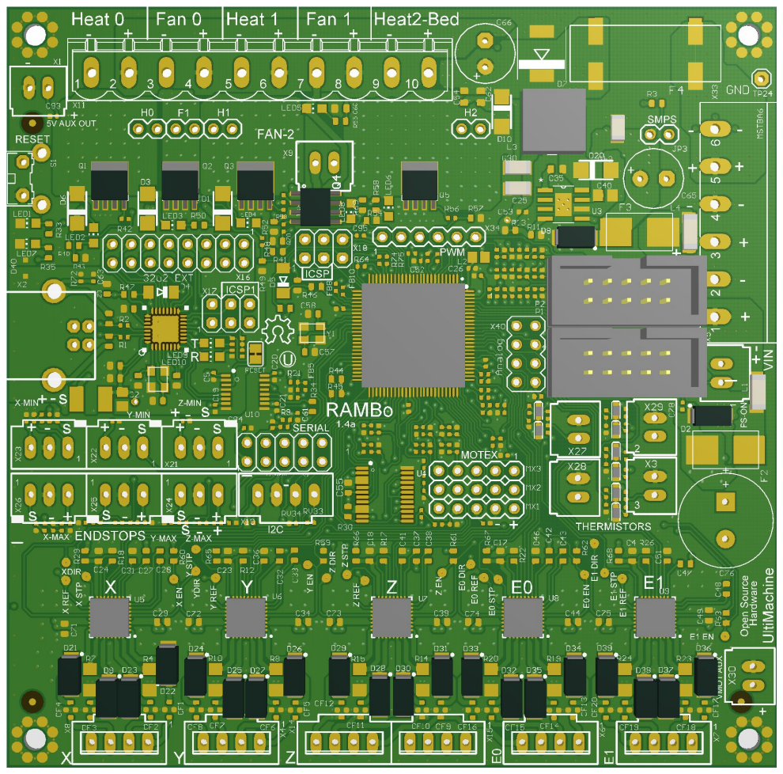
[picture p7: page 1]
