ultimachine/RAMBo-1.4/(list of files, drawings)

Other design files:
Connectors.SchDoc
Endstops.SchDoc
Panels/Rambo_Panel.PcbDoc
Panels/Rambo_Panel.PrjPcb
RAMBo.PcbLib
RAMBo.PrjPcb
RAMBo.SchDoc
RAMBo.SCHLIB
