ultimachine/RAMBo-1.4/(commit log)

2017-07-08 cleanup polygons and most DRC errors
    [RAMBo.PrjPcb, RAMBo.SchDoc]
2017-07-10 Resolve DRCs. mounting holes, masks, thermal vias, etc
    [RAMBo.PcbLib, RAMBo.PrjPcb, RAMBo.SCHLIB, RAMBo.SchDoc]
2017-07-15 adding filtering on endstops and some io
    [Connectors.SchDoc, Endstops.SchDoc, RAMBo.PrjPcb, RAMBo.SchDoc]
2017-07-17 update thermistor circuit, route filters
    [Connectors.SchDoc, Endstops.SchDoc, RAMBo.SchDoc]
2017-07-21 cleanup routing under endstops
    [Connectors.SchDoc, Endstops.SchDoc, RAMBo.SchDoc]
2017-07-22 adding lcd connectors
    [Connectors.SchDoc]
2017-07-22 routing connector changes
    [Connectors.SchDoc]
2017-07-24 rerouting SPI
    [Connectors.SchDoc, Endstops.SchDoc, RAMBo.SchDoc]
2017-07-24 rerouting SPI.connectors
    [Connectors.SchDoc]
2017-07-28 move spi resistor close to MCU pin
    [Connectors.SchDoc]
2017-07-29 MCU decoupling 0402, schematic wires blue
    [Connectors.SchDoc, Endstops.SchDoc, RAMBo.SchDoc]
2017-08-03 6t8c design rules. New 2560 footprint
    [RAMBo.SchDoc]
2017-08-22 add io filters. rough routing.
    [RAMBo.SchDoc]
2017-08-27 most filters placed.
    [Connectors.SchDoc, Endstops.SchDoc, RAMBo.PrjPcb, RAMBo.SchDoc]
2017-08-27 routed filters
    [Connectors.SchDoc]
2017-08-28 trace polygon plane cleanup
2017-08-28 rename power input nets
    [Connectors.SchDoc, RAMBo.SchDoc]
2017-08-28 update SMPS components
    [RAMBo.SchDoc]
2017-08-29 Update motor driver and pass through capacitor footprints
    [RAMBo.PcbLib, RAMBo.SchDoc]
2017-08-29 update paste and solder mask expansion rules
2017-08-29 TVS changed to 28V. Fill in some bom details.
    [Connectors.SchDoc, RAMBo.SchDoc]
2017-08-30 update mosfet circuit
    [RAMBo.PrjPcb, RAMBo.SchDoc]
2017-08-31 add mask stop on bottom of mosfet thermal vias
    [RAMBo.PcbLib, RAMBo.PrjPcb, RAMBo.SchDoc]
2017-08-31 add panel project
    [Rambo_Panel.PcbDoc, Rambo_Panel.PrjPcb]
2017-08-31 add varistor to USB 5V
    [RAMBo.SchDoc]
2017-08-31 tp drill = 10mil
2017-08-31 straighten crooked traces and plane under fets
2017-08-31 add mlv to I2C
    [Connectors.SchDoc, RAMBo.PrjPcb]
2017-09-01 compile 1.4a
    [BOM-Grouped_RAMBo_1.4a.xlsx, Connectors.SchDoc, Endstops.SchDoc, Pick and Place_RAMBo_1.4a.csv, RAMBo.SchDoc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]
2017-09-01 fix bom typos
    [BOM-Grouped_RAMBo_1.4a.xlsx, Connectors.SchDoc, Pick and Place_RAMBo_1.4a.csv, RAMBo.SchDoc]
2017-09-13 Fix network resistor part number
    [RAMBo.SchDoc]
2017-09-13 regenerate assembly files
    [BOM-Grouped_RAMBo_1.4a.xlsx, Pick and Place_RAMBo_1.4a.csv]
